MaxPastushkov/RXProg/README.md

RXProg uses an STM32 to emulate the drum machine's SRAM chips, allowing programming over USB
