MaxPastushkov/RXProg/Micro_USB_10103594.stp

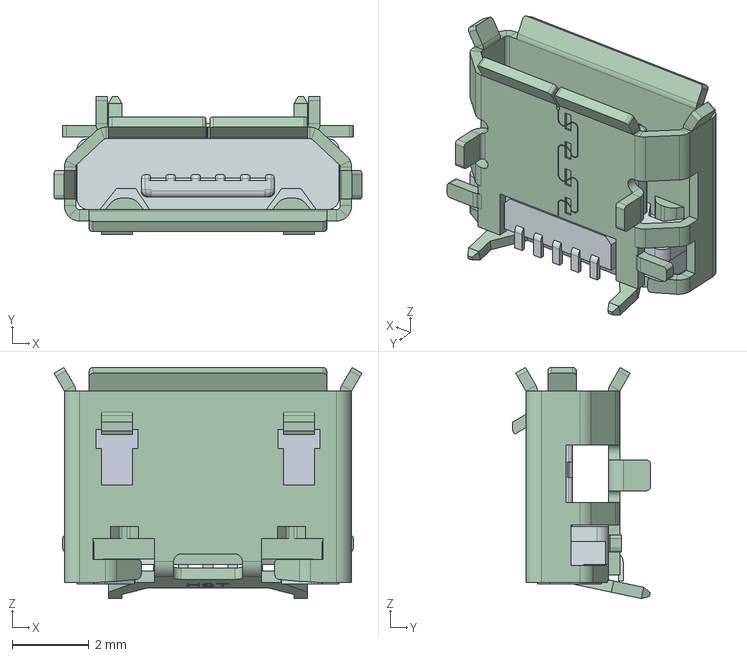
[picture p1: CAD file, 2026-05-27]
Micro_USB_10103594.stp
8.04 x 3.60 x 6.03 mm
