MaxPastushkov/RXProg/RXProg.kicad_pcb

## KiCad design RXProg.kicad_pcb (2026-05-28)

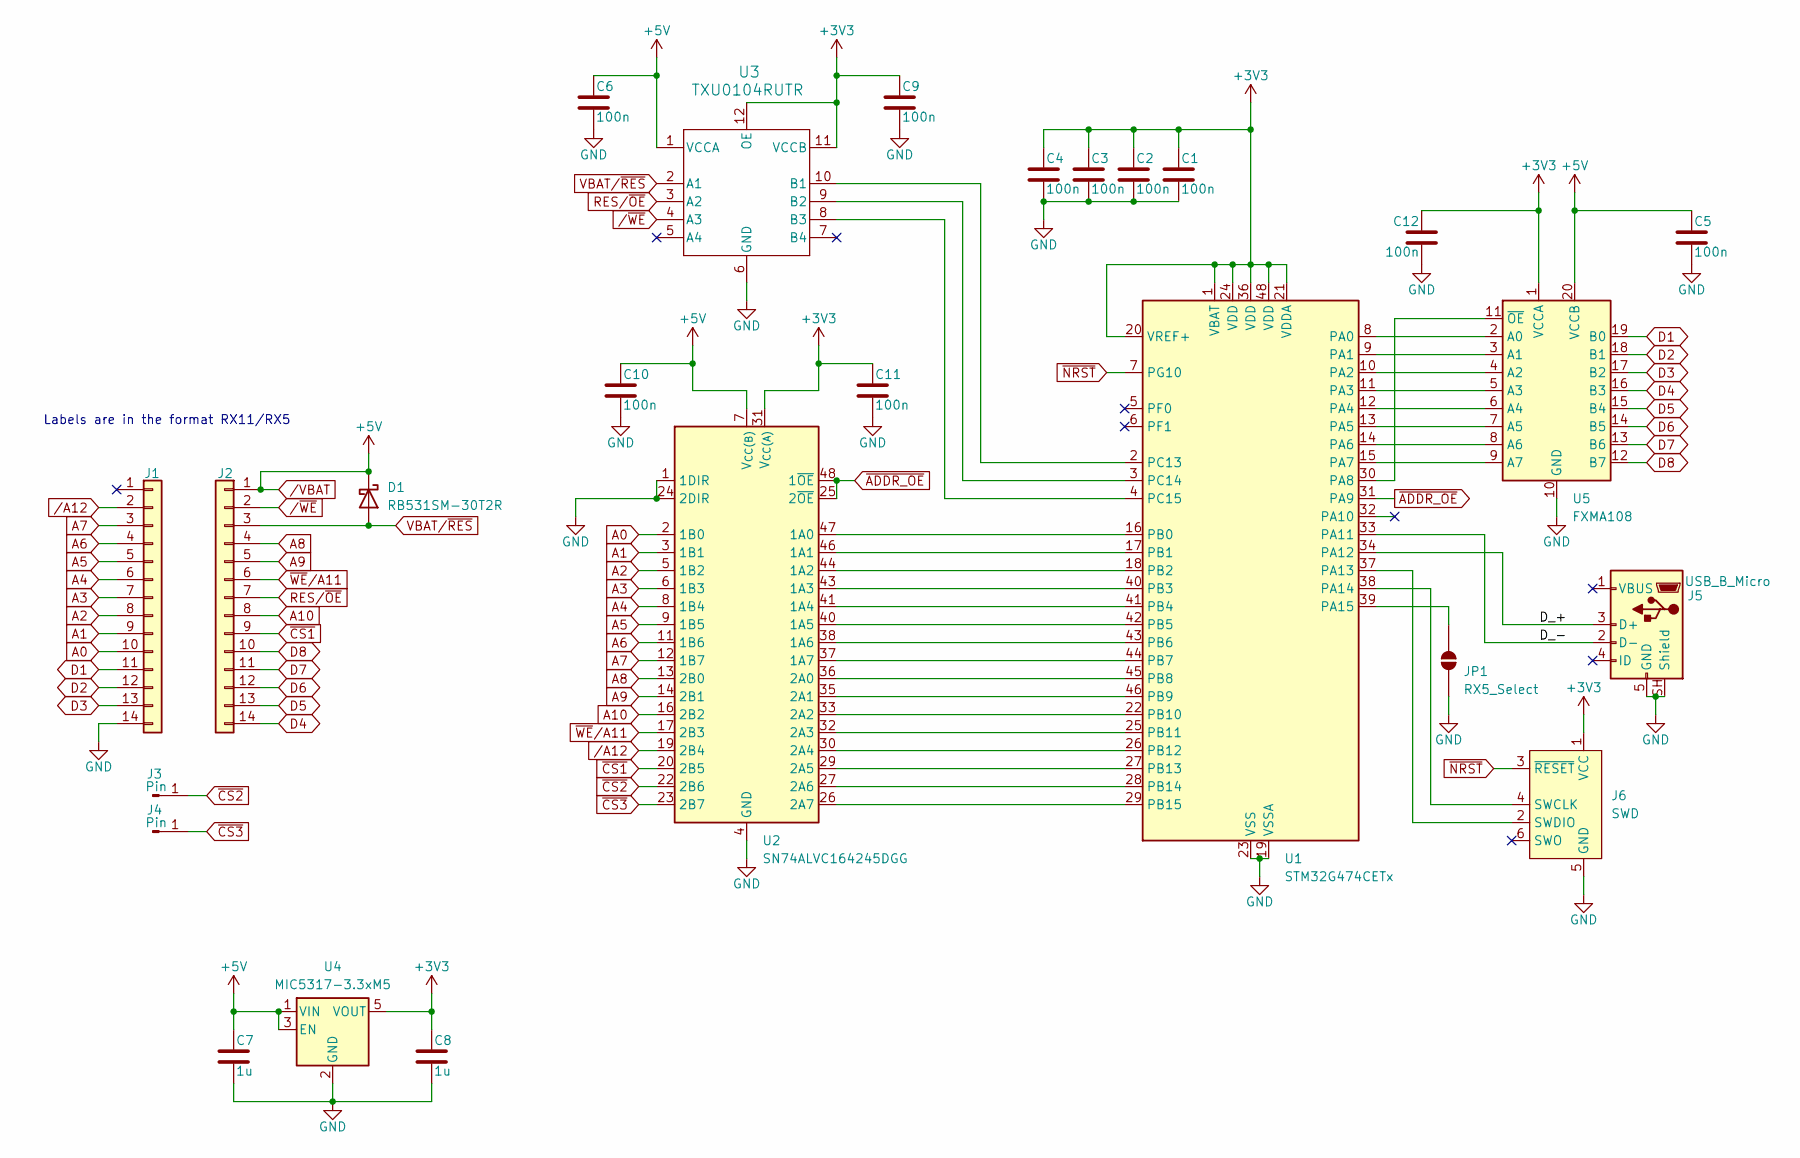
[picture p2: schematic RXProg.kicad_sch]

Parts:
C1, C2, C3, C4, C5, C6, C9, C10, C11, C12: 100n; C_0201_0603Metric
C7, C8: 1u; C_0201_0603Metric
D1: RB531SM-30T2R; D_SOD-523
J1, J2: Conn_01x14; PinHeader_1x14_P2.54mm_Vertical
J3, J4: Pin
J5: USB_B_Micro; USB_Micro-B_Amphenol_10103594-0001LF_Horizontal
J6: SWD; Tag-Connect_TC2030-IDC-NL_2x03_P1.27mm_Vertical
JP1: RX5_Select; SolderJumper-2_P1.3mm_Open_RoundedPad1.0x1.5mm
U1: STM32G474CETx; LQFP-48_7x7mm_P0.5mm
U2: SN74ALVC164245DGG; TSSOP-48_6.1x12.5mm_P0.5mm
U3: TXU0104RUTR; QFN_04RUTR_TEX
U4: MIC5317-3.3xM5; SOT-23-5
U5: FXMA108; WQFN-20-1EP_2.5x4.5mm_P0.5mm_EP1x2.9mm

Connections:
+3V3: C1.1, C2.1, C3.1, C4.1, C8.1, C9.1, C11.1, C12.1, J6.1 (VCC), U1.1 (VBAT), U1.20 (VREF+), U1.21 (VDDA), U1.24 (VDD), U1.36 (VDD), U1.48 (VDD), U2.31 (V_{CC(A)}), U2.42 (V_{CC(A)}), U3.11 (VCCB), U3.12 (OE), U4.5 (VOUT), U5.1 (VCCA)
/D_+: J5.3 (D+), U1.34 (PA12)
/D_-: J5.2 (D-), U1.33 (PA11)
A0: J1.10, U2.2 (1B0)
A1: J1.9, U2.3 (1B1)
A2: J1.8, U2.5 (1B2)
A3: J1.7, U2.6 (1B3)
A4: J1.6, U2.8 (1B4)
A5: J1.5, U2.9 (1B5)
A6: J1.4, U2.11 (1B6)
A7: J1.3, U2.12 (1B7)
A8: J2.4, U2.13 (2B0)
A9: J2.5, U2.14 (2B1)
A10: J2.8, U2.16 (2B2)
D1: J1.11, U5.19 (B0)
D2: J1.12, U5.18 (B1)
D3: J1.13, U5.17 (B2)
D4: J2.14, U5.16 (B3)
D5: J2.13, U5.15 (B4)
D6: J2.12, U5.14 (B5)
D7: J2.11, U5.13 (B6)
D8: J2.10, U5.12 (B7)
GND: C1.2, C2.2, C3.2, C4.2, C5.2, C6.2, C7.2, C8.2, C9.2, C10.2, C11.2, C12.2, J1.14, J5.5 (GND), J5.SH (Shield), J6.5 (GND), JP1.1 (A), U1.19 (VSSA), U1.23 (VSS), U1.35 (VSS), U1.47 (VSS), U2.1 (1DIR), U2.4 (GND), U2.10 (GND), U2.15 (GND), U2.21 (GND), U2.24 (2DIR), U2.28 (GND), U2.34 (GND), U2.39 (GND), U2.45 (GND), U3.6 (GND), U4.2 (GND), U5.10 (GND)
unnamed: J6.4 (SWCLK), U1.38 (PA14)
unnamed: J6.2 (SWDIO), U1.37 (PA13)
unnamed: JP1.2 (B), U1.39 (PA15)
unnamed: U1.8 (PA0), U5.2 (A0)
unnamed: U1.9 (PA1), U5.3 (A1)
unnamed: U1.10 (PA2), U5.4 (A2)
unnamed: U1.11 (PA3), U5.5 (A3)
unnamed: U1.12 (PA4), U5.6 (A4)
unnamed: U1.13 (PA5), U5.7 (A5)
unnamed: U1.14 (PA6), U5.8 (A6)
unnamed: U1.15 (PA7), U5.9 (A7)
unnamed: U1.30 (PA8), U5.11 (~OE)
unnamed: U1.16 (PB0), U2.47 (1A0)
unnamed: U1.17 (PB1), U2.46 (1A1)
unnamed: U1.18 (PB2), U2.44 (1A2)
unnamed: U1.40 (PB3), U2.43 (1A3)
unnamed: U1.41 (PB4), U2.41 (1A4)
unnamed: U1.42 (PB5), U2.40 (1A5)
unnamed: U1.43 (PB6), U2.38 (1A6)
unnamed: U1.44 (PB7), U2.37 (1A7)
unnamed: U1.45 (PB8), U2.36 (2A0)
unnamed: U1.46 (PB9), U2.35 (2A1)
unnamed: U1.22 (PB10), U2.33 (2A2)
unnamed: U1.25 (PB11), U2.32 (2A3)
unnamed: U1.26 (PB12), U2.30 (2A4)
unnamed: U1.27 (PB13), U2.29 (2A5)
unnamed: U1.28 (PB14), U2.27 (2A6)
unnamed: U1.29 (PB15), U2.26 (2A7)
unnamed: U1.2 (PC13), U3.10 (B1)
unnamed: U1.3 (PC14), U3.9 (B2)
unnamed: U1.4 (PC15), U3.8 (B3)
RES/~OE: J2.7, U3.3 (A2)
VBAT/~RES: D1.2 (A), J2.3, U3.2 (A1)
/A12: J1.2, U2.19 (2B4)
/VBAT: C5.1, C6.1, C7.1, C10.1, D1.1 (K), J2.1, U2.7 (V_{CC(B)}), U2.18 (V_{CC(B)}), U3.1 (VCCA), U4.1 (VIN), U4.3 (EN), U5.20 (VCCB)
/~WE: J2.2, U3.4 (A3)
~ADDR_OE: U1.31 (PA9), U2.25 (2~OE), U2.48 (1~OE)
~CS1: J2.9, U2.20 (2B5)
~CS2: J3.1 (Pin_1_1), U2.22 (2B6)
~CS3: J4.1 (Pin_1_1), U2.23 (2B7)
~NRST: J6.3 (~RESET), U1.7 (PG10)
~WE/A11: J2.6, U2.17 (2B3)

Notes on the sheet:
Labels are in the format RX11/RX5

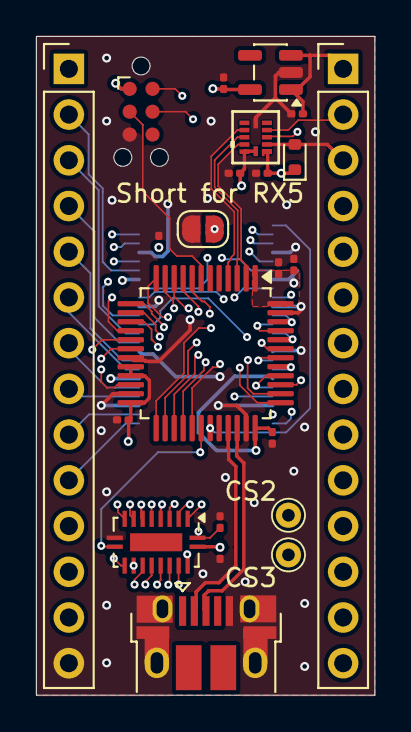
[picture p3: board RXProg.kicad_pcb from above]

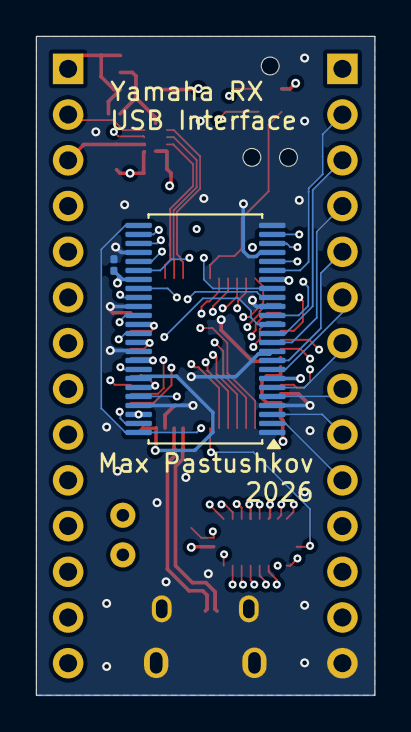
[picture p4: board RXProg.kicad_pcb from below]

Board: 6 copper layers, 18.8 x 36.6 mm, 25 parts (2 on the bottom side), 65 nets.
