MaxPastushkov/RXProg/RXProg-firmware/RXProg-firmware.ioc

Mcu.UserName=STM32G474CETx
PA0.GPIO_Label=D0
PA0.Signal=GPIO_Output
PA1.GPIO_Label=D1
PA1.Signal=GPIO_Output
PA11.Signal=USB_DM
PA12.Signal=USB_DP
PA15.GPIO_Label=RX5
PA15.Signal=GPIO_Input
PA2.GPIO_Label=D2
PA2.Signal=GPIO_Output
PA3.GPIO_Label=D3
PA3.Signal=GPIO_Output
PA4.GPIO_Label=D4
PA4.Signal=GPIO_Output
PA5.GPIO_Label=D5
PA5.Signal=GPIO_Output
PA6.GPIO_Label=D6
PA6.Signal=GPIO_Output
PA7.GPIO_Label=D7
PA7.Signal=GPIO_Output
PA8.GPIO_Label=DATA_OE
PA8.Signal=GPIO_Output
PA9.GPIO_Label=ADDR_OE
PA9.Signal=GPIO_Output
PB0.GPIO_Label=A0
PB0.Signal=GPIO_Input
PB1.GPIO_Label=A1
PB1.Signal=GPIO_Input
PB10.GPIO_Label=A10
PB10.Signal=GPIO_Input
PB11.GPIO_Label=WE/A11
PB11.Signal=GPIO_Input
PB12.GPIO_Label=A12
PB12.Signal=GPIO_Input
PB13.GPIO_Label=CS1
PB13.Signal=GPXTI13
PB14.GPIO_Label=CS2
PB14.Signal=GPXTI14
PB15.GPIO_Label=CS3
PB15.Signal=GPXTI15
PB2.GPIO_Label=A2
PB2.Signal=GPIO_Input
PB3.GPIO_Label=A3
PB3.Signal=GPIO_Input
PB4.GPIO_Label=A4
PB4.Signal=GPIO_Input
PB5.GPIO_Label=A5
PB5.Signal=GPIO_Input
PB6.GPIO_Label=A6
PB6.Signal=GPIO_Input
PB7.GPIO_Label=A7
PB7.Signal=GPIO_Input
PB8-BOOT0.GPIO_Label=A8
PB8-BOOT0.Signal=GPIO_Input
PB9.GPIO_Label=A9
PB9.Signal=GPIO_Input
PC13.GPIO_Label=VBAT/RES
PC13.Signal=GPIO_Input
PC14-OSC32_IN.GPIO_Label=RES/OE
PC14-OSC32_IN.Signal=GPIO_Input
PC15-OSC32_OUT.GPIO_Label=WE
PC15-OSC32_OUT.Signal=GPIO_Input
