MaxPastushkov/RXProg/(commit log)

2026-05-20 Add level shifters
    [RXProg.kicad_pcb, RXProg.kicad_sch]
2026-05-21 Start routing
    [RXProg.kicad_pcb, RXProg.kicad_sch]
2026-05-22 Finished routing
    [RXProg.kicad_pcb, RXProg.kicad_sch]
2026-05-27 Finish routing (again)
    [Micro_USB_10103594.stp, RXProg.kicad_pcb, RXProg.kicad_sch, bom.csv, designators.csv, positions.csv]
2026-05-28 Time to reroute! (again)
    [BOM-RXProg.csv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]
2026-05-28 Fix vias
    [RXProg-CuBottom.gbr, RXProg-CuIn1.gbr, RXProg-CuIn2.gbr, RXProg-CuIn3.gbr, RXProg-CuIn4.gbr, RXProg-CuTop.gbr, RXProg-EdgeCuts.gbr, RXProg-MaskBottom.gbr]
2026-05-28 Add jumper text
    [RXProg.kicad_pcb]
